NickZ1969/Teensy8x8_Hardware/teensy 8x8/Schematic_Teensy8x8.png

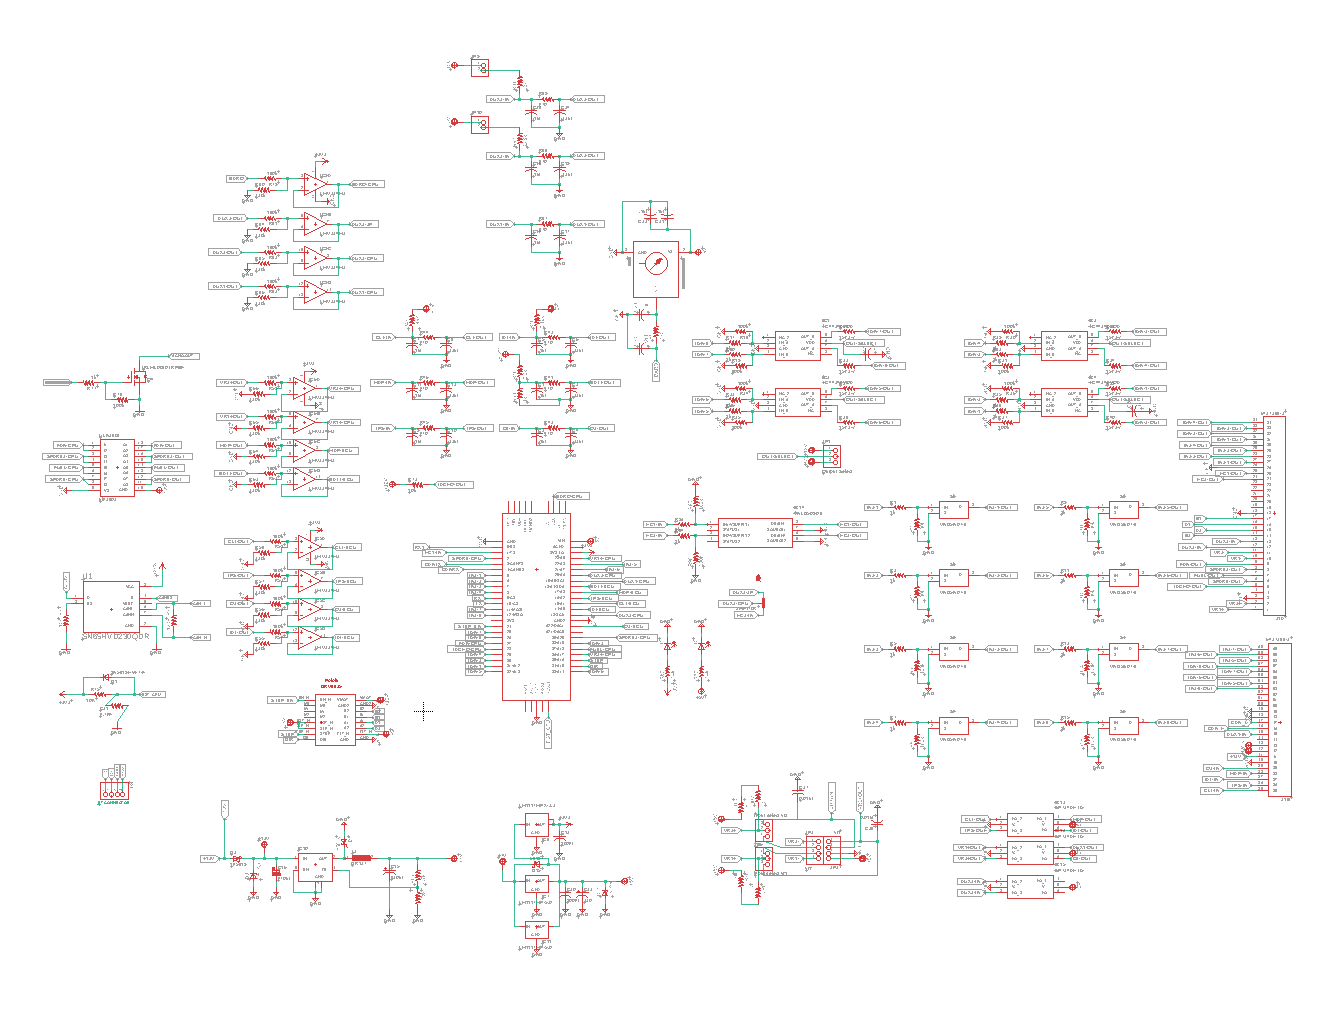
teensy 8x8/Schematic_Teensy8x8.png
