NickZ1969/Teensy8x8_Hardware/teensy 8x8/teensy8x826pin.png

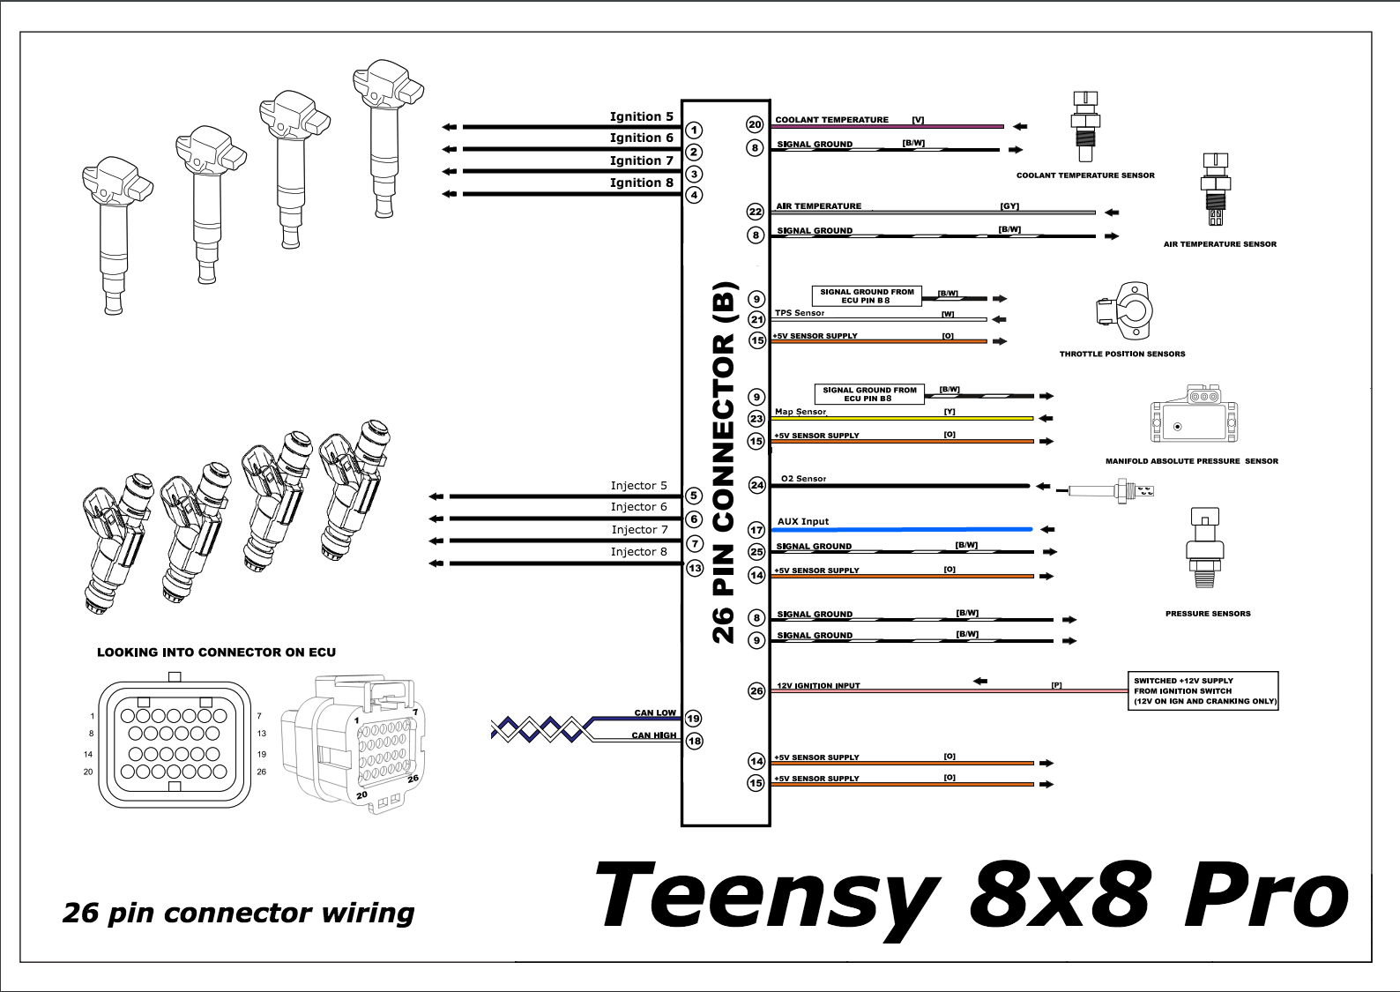
teensy 8x8/teensy8x826pin.png
