NickZ1969/Teensy8x8_Hardware/teensy 8x8/Teensy8x834pin.png

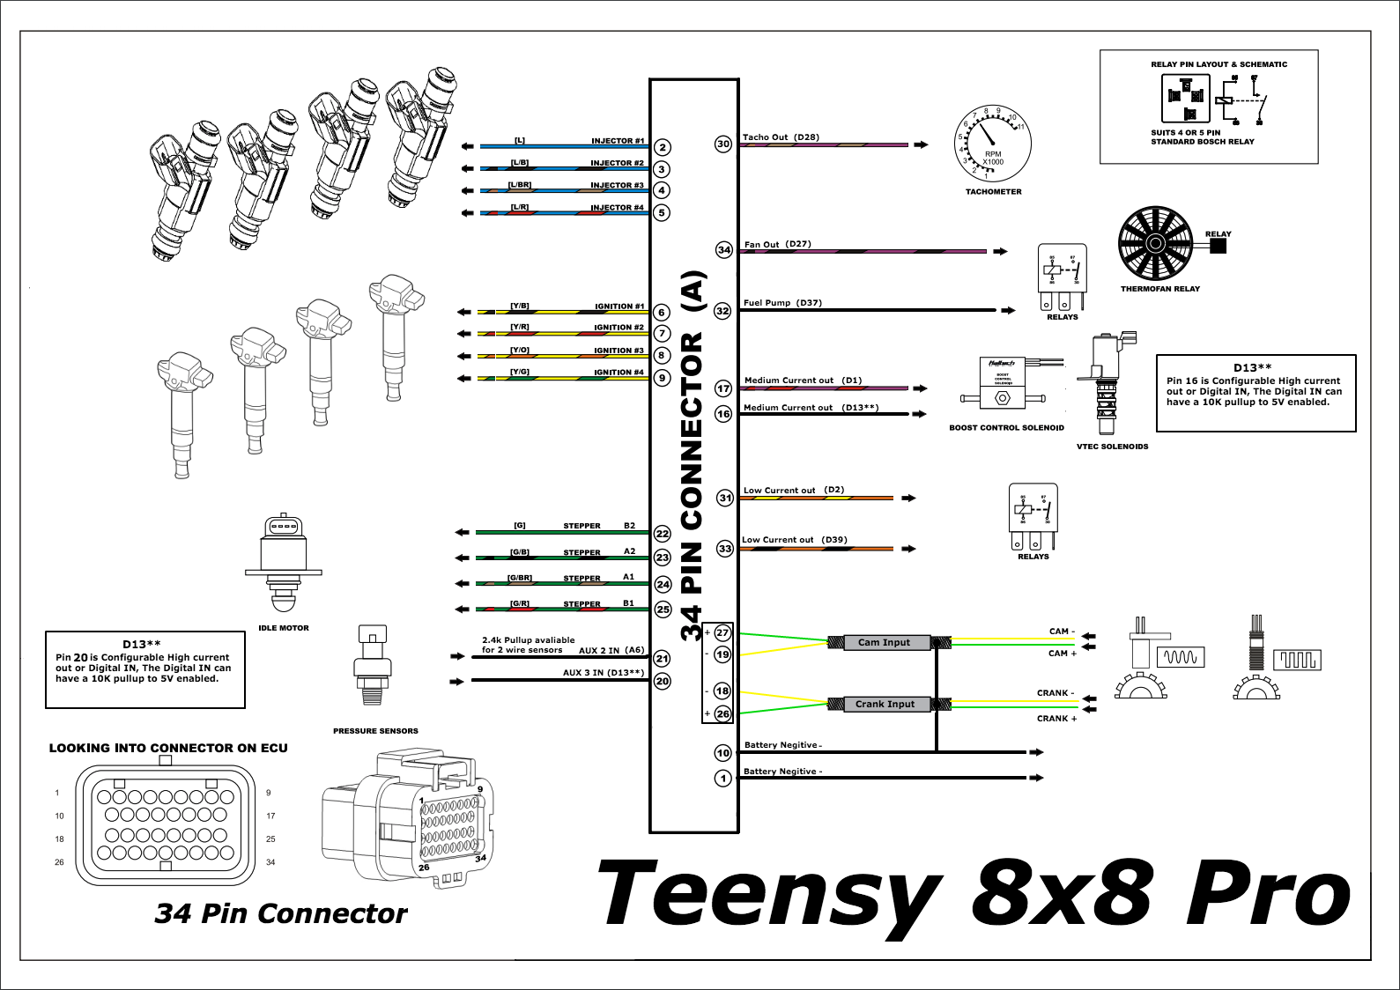
teensy 8x8/Teensy8x834pin.png
