NickZ1969/Teensy8x8_Hardware/teensy 8x8/teensy_speeduino_5.1.brd

## EAGLE design teensy 8x8/teensy_speeduino_5.1.brd (2020-06-06)

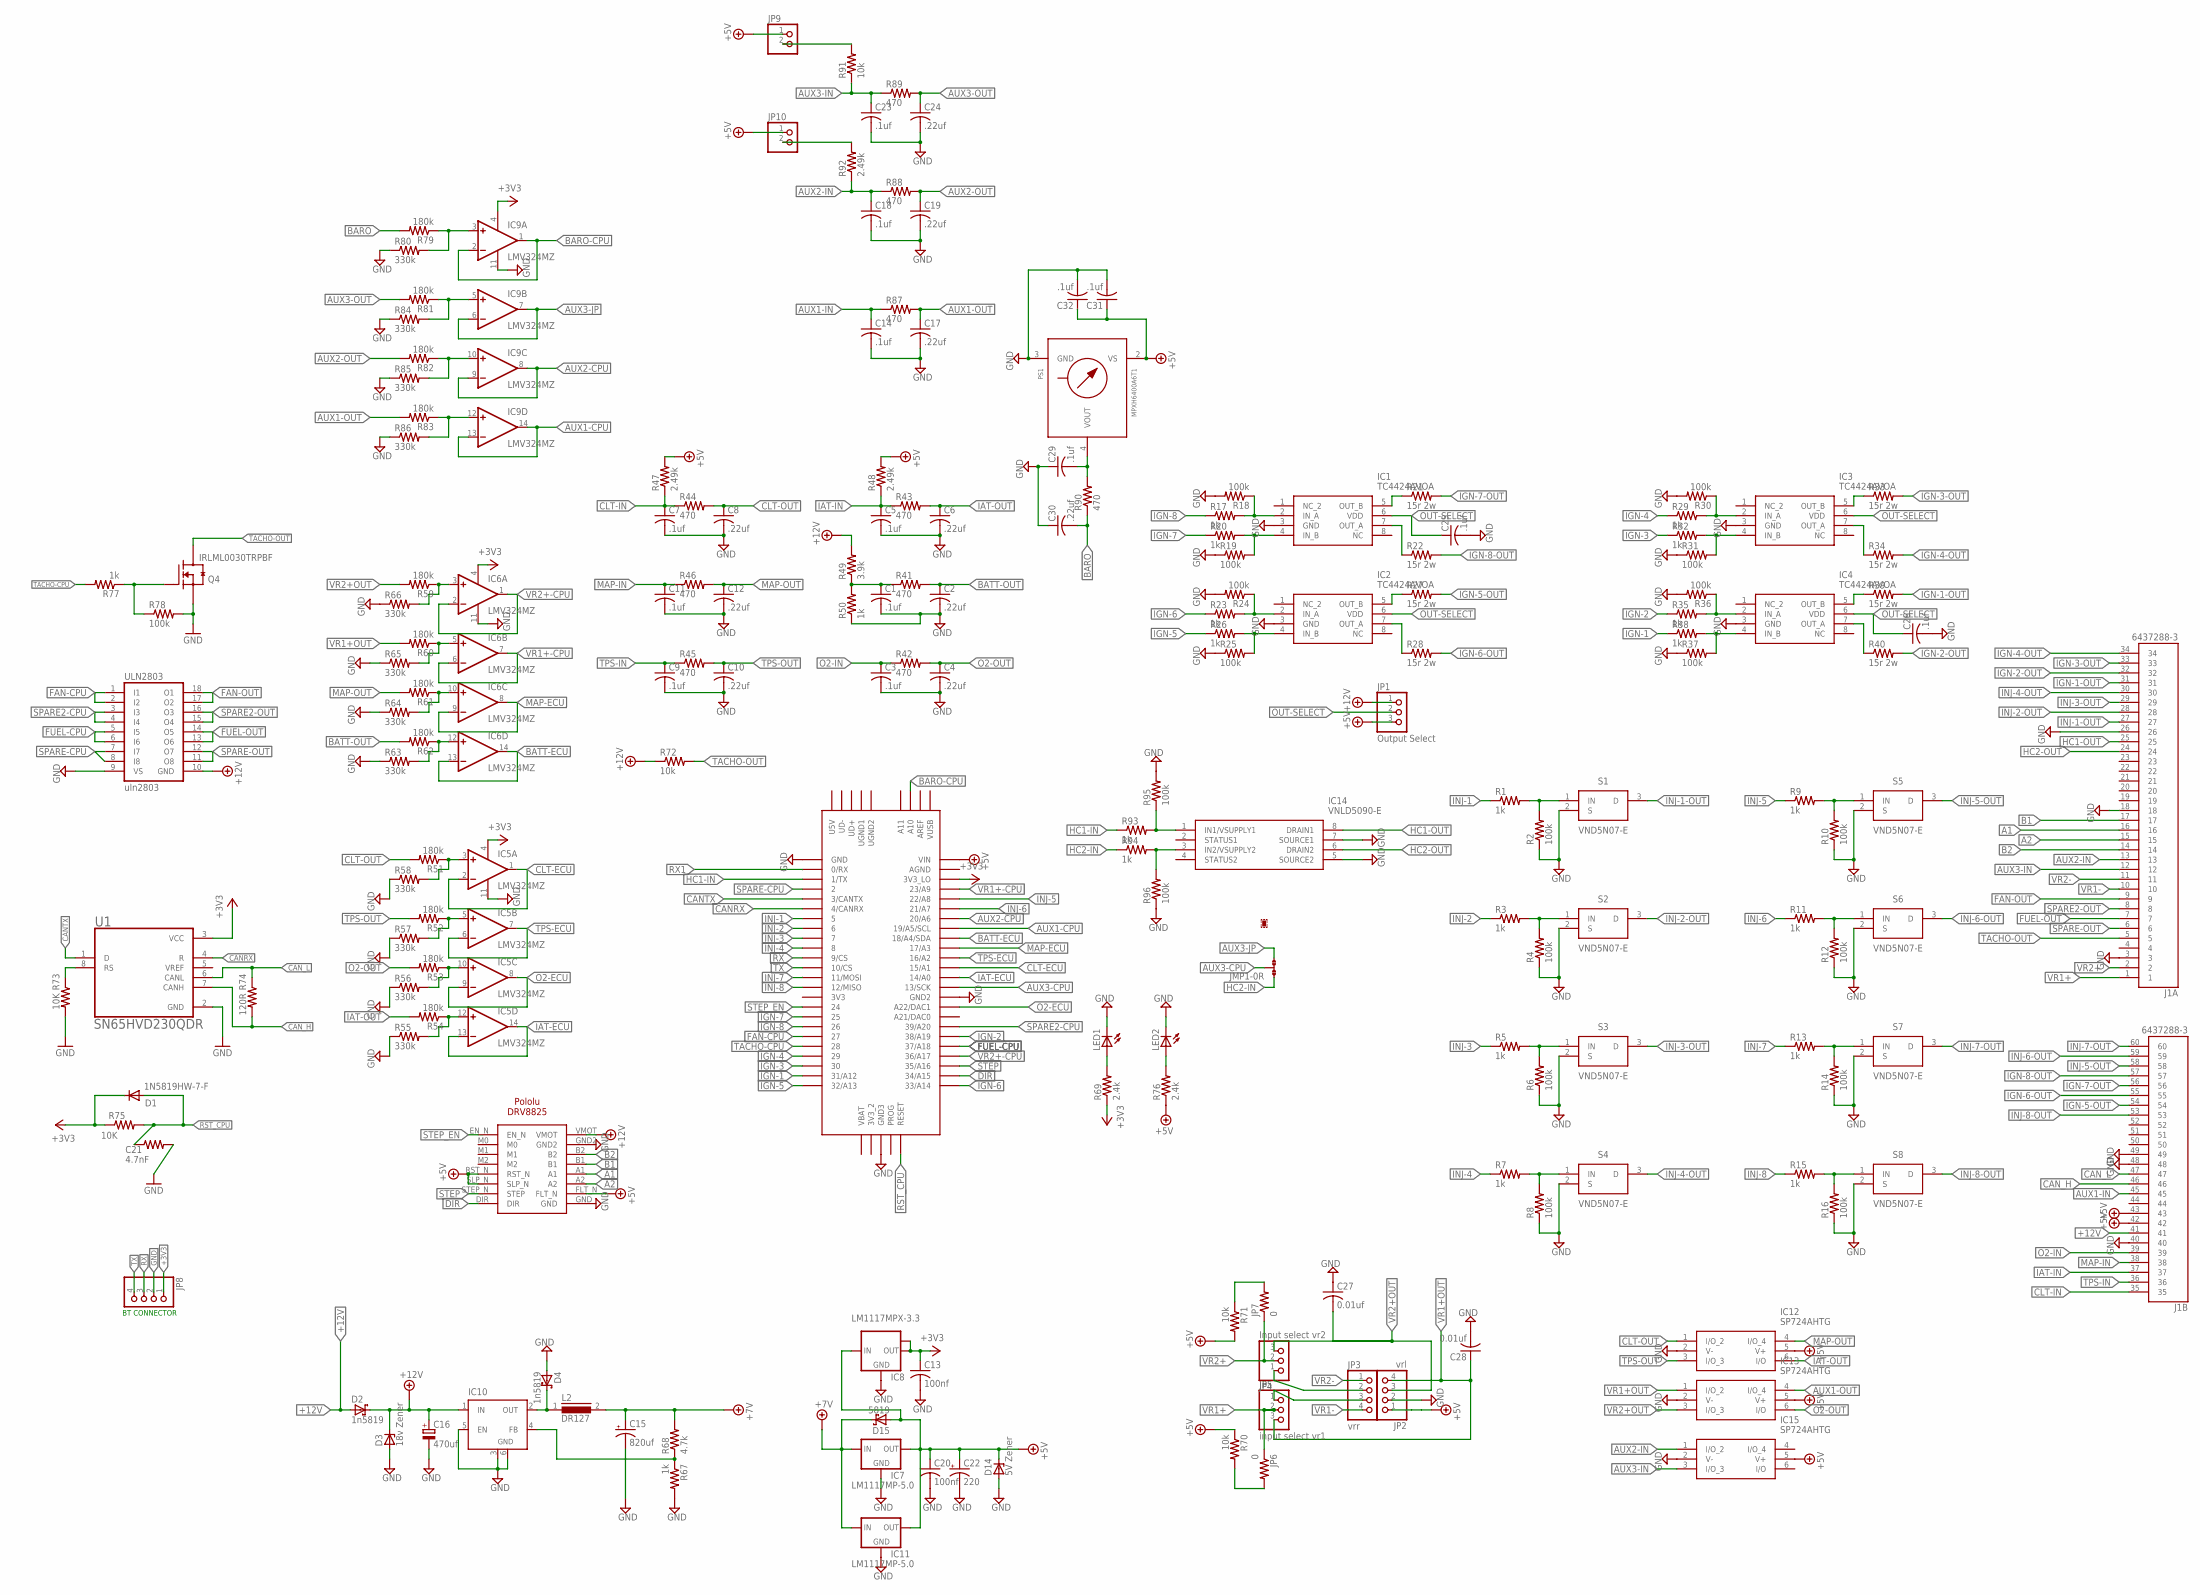
[picture p4: schematic teensy_speeduino_5.1.sch]

Parts:
C1, C3, C5, C7, C9, C11, C29, C31, C32: .1uf; C1206
C2, C4, C6, C8, C10, C12, C30: .22uf; C1206
C13, C20: 100nf; C1206
C14, C18, C23, C25, C26: .1uf; C0805
C15: 820uf; 153CLV-0810
C16: 470uf; 153CLV-0810
C17, C19, C24: .22uf; C0805
C21: 4.7nF; R1206
C22: 220; 153CLV-0605
C27, C28: 0.01uf; C1206
D1: 1N5819HW-7-F; SOD123
D2, D4: 1n5819; SMB
D3: 18v Zener; SMB
D14: 5V Zener; SMB
D15: 5819; SMB
IC1, IC2, IC3, IC4: TC4424AVOA; SOIC127P600X175-8N
IC5, IC6, IC9: LMV324MZ; TSSOP14
IC7, IC11: LM1117MP-5.0; SOT223
IC8: LM1117MPX-3.3; SOT223
IC10: LM2596S; TO263-5
IC12, IC13, IC15: SP724AHTG; SOT95P280X145-6N
IC14: VNLD5090-E; SOIC127P600X175-8N
J1: 6437288-3; TE_6437288-3
JMP1: 0R-JUMPA; A0R-JMP
JP1: Output Select; 1X03
JP2: vrl; 1X04
JP3: vrr; 1X04
JP4: Input select vr2; 1X03
JP5: input select vr1; 1X03
JP6, JP7: 0; R0805
JP8: PINHD-1X4; 1X04
JP9, JP10: PINHD-1X2; 1X02
L2: DR127
LED1, LED2: LEDSML1206; SML1206
PS1: MPXH6400A6T1; 1317
Q4: IRLML0030TRPBF; SOT95P280X135-3N
R1, R3, R5, R7, R9, R11, R13, R15, R17, R20, R23, R26, R29, R32, R35, R38, R50, R67, R77, R93, R94: 1k; R1206
R2, R4, R6, R8, R10, R12, R14, R16, R18, R19, R24, R25, R30, R31, R36, R37, R78, R95, R96: 100k; R1206
R21, R22, R27, R28, R33, R34, R39, R40: 15r 2w; R2512
R41, R42, R43, R44, R45, R46, R90: 470; R1206
R47, R48, R92: 2.49k; R1206
R49: 3.9k; R1206
R51, R52, R53, R54, R59, R60, R61, R62: 180k; R1206
R55, R56, R57, R58, R63, R64, R65, R66: 330k; R1206
R68: 4.7k; R1206
R69, R76: 2.4k; R1206
R70, R71, R72, R91: 10k; R1206
R73, R75: 10K; R1206
R74: 120R; R1206
R79, R81, R82, R83: 180k; R0805
R80, R84, R85, R86: 330k; R0805
R87, R88, R89: 470; R0805
S1, S2, S3, S4, S5, S6, S7, S8: VND5N07-E; TO-252-(DPAK)_1
U1: SN65HVD230QDR; SOIC127P600X175-8N
U$1: TEENSY_3.5/3.6
U$3: POLOLU-DRV8825
ULN2803: uln2803; SO18W

Connections:
+3V3: C13.1, D1.C, IC5.4 (V+), IC6.4 (V+), IC8.2 (OUT), IC8.TAB (OUT1), IC9.4 (V+), JP8.1, R69.1, R75.1, U1.3 (VCC), U$1.3V3_LO
+5V: C20.1, C22.+, C31.1, C32.1, D14.C, D15.A, IC7.2 (OUT), IC7.4 (OUT), IC8.3 (IN), IC11.2 (OUT), IC11.4 (OUT), IC12.5 (V+), IC13.5 (V+), IC15.5 (V+), J1.42, J1.43, JP1.3, JP2.1, JP9.1, JP10.1, PS1.2 (VS), R47.2, R48.2, R70.1, R71.2, R76.1, U$1.VIN, U$3.FLT_N, U$3.RST_N, U$3.SLP_N
+7V: C15.+, D15.C, IC7.3 (IN), IC11.3 (IN), L2.2, R68.2
+12V: C16.+, D2.A, D2.C, D3.C, IC10.1 (IN), J1.41, JP1.1, R49.2, R72.1, U$3.VMOT, ULN2803.10 (GND)
A1: J1.16, U$3.A1
A2: J1.15, U$3.A2
AUX1-CPU: IC9.13 (-IN), IC9.14 (OUT), U$1.19/A5/SCL
AUX1-IN: C14.1, J1.45, R87.1
AUX1-OUT: C17.1, IC13.4 (I/O_4), R83.2, R87.2
AUX2-CPU: IC9.8 (OUT), IC9.9 (-IN), U$1.20/A6
AUX2-IN: C18.1, IC15.1 (I/O_2), J1.13, R88.1, R92.1
AUX2-OUT: C19.1, R82.2, R88.2
AUX3-CPU: JMP1.2, U$1.13/SCK
AUX3-IN: C23.1, IC15.3 (I/O_3), J1.12, R89.1, R91.1
AUX3-JP: IC9.6 (-IN), IC9.7 (OUT), JMP1.3
AUX3-OUT: C24.1, R81.2, R89.2
B1: J1.17, U$3.B1
B2: J1.14, U$3.B2
BARO: C30.2, R79.2, R90.1
BARO-CPU: IC9.1 (OUT), IC9.2 (-IN), U$1.A10
BATT-ECU: IC6.13 (-IN), IC6.14 (OUT), U$1.18/A4/SDA
BATT-OUT: C2.1, R41.2, R62.2
CANRX: U1.4 (R), U$1.4/CANRX
CANTX: U1.1 (D), U$1.3/CANTX
CAN_H: J1.46, R74.2, U1.7 (CANH)
CAN_L: J1.47, R74.1, U1.6 (CANL)
CLT-ECU: IC5.1 (OUT), IC5.2 (-IN), U$1.15/A1
CLT-IN: C7.1, J1.35, R44.1, R47.1
CLT-OUT: C8.1, IC12.1 (I/O_2), R44.2, R51.2
DIR: U$1.34/A15, U$3.DIR
FAN-CPU: U$1.27, ULN2803.1 (I1), ULN2803.2 (I2)
FAN-OUT: J1.9, ULN2803.17 (O2), ULN2803.18 (O1)
FUEL-CPU: U$1.37/A18, ULN2803.5 (I5), ULN2803.6 (I6)
FUEL-OUT: J1.7, ULN2803.13 (O6), ULN2803.14 (O5)
GND: C1.2, C2.2, C3.2, C4.2, C5.2, C6.2, C7.2, C8.2, C9.2, C10.2, C11.2, C12.2, C13.2, C14.2, C15.-, C16.-, C17.2, C18.2, C19.2, C20.2, C21.2, C22.-, C23.2, C24.2, C25.2, C26.2, C27.1, C28.2, C29.1, C30.1, C31.2, C32.2, D3.A, D4.A, D14.A, IC1.3 (GND), IC2.3 (GND), IC3.3 (GND), IC4.3 (GND), IC5.11 (V-), IC6.11 (V-), IC7.1 (GND), IC8.1 (GND), IC9.11 (V-), IC10.3 (GND), IC10.5 (EN), IC10.6 (GND), IC11.1 (GND), IC12.2 (V-), IC13.2 (V-), IC14.5 (SOURCE2), IC14.7 (SOURCE1), IC15.2 (V-), J1.3, J1.18, J1.26, J1.40, J1.48, J1.49, JP2.2, JP8.2, LED1.C, LED2.C, PS1.3 (GND), Q4.2 (S), R2.1, R4.1, R6.1, R8.1, R10.1, R12.1, R14.1, R16.1, R18.2, R19.1, R24.2, R25.1, R30.2, R31.1, R36.2, R37.1, R50.1, R55.1, R56.1, R57.1, R58.1, R63.1, R64.1, R65.1, R66.1, R67.2, R73.2, R78.2, R80.1, R84.1, R85.1, R86.1, R95.2, R96.1, S1.2 (S), S2.2 (S), S3.2 (S), S4.2 (S), S5.2 (S), S6.2 (S), S7.2 (S), S8.2 (S), U1.2 (GND), U$1.GND, U$1.GND2, U$1.GND3, U$3.GND, U$3.GND2, ULN2803.9 (VS)
HC1-IN: R93.1, U$1.1/TX
HC1-OUT: IC14.8 (DRAIN1), J1.25
HC2-IN: JMP1.1, R94.1
HC2-OUT: IC14.6 (DRAIN2), J1.24
IAT-ECU: IC5.13 (-IN), IC5.14 (OUT), U$1.14/A0
IAT-IN: C5.1, J1.37, R43.1, R48.1
IAT-OUT: C6.1, IC12.6 (I/O), R43.2, R54.2
IGN-1: R38.1, U$1.31/A12
IGN-1-OUT: J1.31, R39.2
IGN-2: R35.1, U$1.38/A19
IGN-2-OUT: J1.32, R40.2
IGN-3: R32.1, U$1.30
IGN-3-OUT: J1.33, R33.2
IGN-4: R29.1, U$1.29
IGN-4-OUT: J1.34, R34.2
IGN-5: R26.1, U$1.32/A13
IGN-5-OUT: J1.54, R27.2
IGN-6: R23.1, U$1.33/A14
IGN-6-OUT: J1.55, R28.2
IGN-7: R20.1, U$1.25
IGN-7-OUT: J1.56, R21.2
IGN-8: R17.1, U$1.26
IGN-8-OUT: J1.57, R22.2
INJ-1: R1.1, U$1.5
INJ-1-OUT: J1.27, S1.3 (D)
INJ-2: R3.1, U$1.6
INJ-2-OUT: J1.28, S2.3 (D)
INJ-3: R5.1, U$1.7
INJ-3-OUT: J1.29, S3.3 (D)
INJ-4: R7.1, U$1.8
INJ-4-OUT: J1.30, S4.3 (D)
INJ-5: R9.1, U$1.22/A8
INJ-5-OUT: J1.58, S5.3 (D)
INJ-6: R11.1, U$1.21/A7
INJ-6-OUT: J1.59, S6.3 (D)
INJ-7: R13.1, U$1.11/MOSI
INJ-7-OUT: J1.60, S7.3 (D)
INJ-8: R15.1, U$1.12/MISO
INJ-8-OUT: J1.53, S8.3 (D)
MAP-ECU: IC6.8 (OUT), IC6.9 (-IN), U$1.17/A3
MAP-IN: C11.1, J1.38, R46.1
MAP-OUT: C12.1, IC12.4 (I/O_4), R46.2, R61.2
unnamed: R1.2, R2.2, S1.1 (IN)
unnamed: R3.2, R4.2, S2.1 (IN)
unnamed: JP3.3, JP5.1
unnamed: JP6.2, R70.2
unnamed: LED2.A, R76.2
unnamed: JP7.2, R71.1
unnamed: R5.2, R6.2, S3.1 (IN)
unnamed: IC1.7 (OUT_A), R22.1
unnamed: IC10.4 (FB), R67.1, R68.1
unnamed: R7.2, R8.2, S4.1 (IN)
unnamed: D4.C, IC10.2 (OUT), L2.1
unnamed: R73.1, U1.8 (RS)
unnamed: R9.2, R10.2, S5.1 (IN)
unnamed: LED1.A, R69.2
unnamed: Q4.1 (G), R77.1, R78.1
unnamed: R11.2, R12.2, S6.1 (IN)
unnamed: IC2.7 (OUT_A), R28.1
unnamed: IC9.3 (+IN), R79.1, R80.2
unnamed: R13.2, R14.2, S7.1 (IN)
unnamed: IC3.7 (OUT_A), R34.1
unnamed: JP10.2, R92.2
unnamed: R15.2, R16.2, S8.1 (IN)
unnamed: IC4.7 (OUT_A), R40.1
unnamed: C29.2, PS1.4 (VOUT), R90.2
unnamed: IC1.2 (IN_A), R17.2, R18.1
unnamed: IC1.4 (IN_B), R19.2, R20.2
unnamed: IC1.5 (OUT_B), R21.1
unnamed: IC14.1 (IN1/VSUPPLY1), R93.2, R95.1
unnamed: IC2.2 (IN_A), R23.2, R24.1
unnamed: IC2.4 (IN_B), R25.2, R26.2
unnamed: IC2.5 (OUT_B), R27.1
unnamed: JP3.2, JP4.1
unnamed: IC3.2 (IN_A), R29.2, R30.1
unnamed: IC3.4 (IN_B), R31.2, R32.2
unnamed: IC3.5 (OUT_B), R33.1
unnamed: IC14.3 (IN2/VSUPPLY2), R94.2, R96.2
unnamed: IC4.2 (IN_A), R35.2, R36.1
unnamed: IC4.4 (IN_B), R37.2, R38.2
unnamed: IC4.5 (OUT_B), R39.1
unnamed: JP9.2, R91.2
unnamed: IC6.3 (+IN), R59.1, R66.2
unnamed: C1.1, R41.1, R49.1, R50.2
unnamed: IC5.3 (+IN), R51.1, R58.2
unnamed: IC5.5 (+IN), R52.1, R57.2
unnamed: IC5.10 (+IN), R53.1, R56.2
unnamed: IC5.12 (+IN), R54.1, R55.2
unnamed: IC9.5 (+IN), R81.1, R84.2
unnamed: IC6.5 (+IN), R60.1, R65.2
unnamed: IC6.10 (+IN), R61.1, R64.2
unnamed: IC6.12 (+IN), R62.1, R63.2
unnamed: IC9.10 (+IN), R82.1, R85.2
unnamed: IC9.12 (+IN), R83.1, R86.2
O2-ECU: IC5.8 (OUT), IC5.9 (-IN), U$1.A22/DAC1
O2-IN: C3.1, J1.39, R42.1
O2-OUT: C4.1, IC13.6 (I/O), R42.2, R53.2
OUT-SELECT: C25.1, C26.1, IC1.6 (VDD), IC2.6 (VDD), IC3.6 (VDD), IC4.6 (VDD), JP1.2
RST_CPU: C21.1, D1.A, R75.2, U$1.RESET
RX: JP8.3, U$1.9/CS
RX1: U$1.0/RX
SPARE2-CPU: U$1.39/A20, ULN2803.3 (I3), ULN2803.4 (I4)
SPARE2-OUT: J1.8, ULN2803.15 (O4), ULN2803.16 (O3)
SPARE-CPU: U$1.2, ULN2803.7 (I7), ULN2803.8 (I8)
SPARE-OUT: J1.6, ULN2803.11 (O8), ULN2803.12 (O7)
STEP: U$1.35/A16, U$3.STEP_N (STEP)
STEP_EN: U$1.24, U$3.EN_N
TACHO-CPU: R77.2, U$1.28
TACHO-OUT: J1.5, Q4.3 (D), R72.2
TPS-ECU: IC5.6 (-IN), IC5.7 (OUT), U$1.16/A2
TPS-IN: C9.1, J1.36, R45.1
TPS-OUT: C10.1, IC12.3 (I/O_3), R45.2, R52.2
TX: JP8.4, U$1.10/CS
VR1+: J1.1, JP5.2, JP6.1
VR1+-CPU: IC6.6 (-IN), IC6.7 (OUT), U$1.23/A9
VR1+OUT: C28.1, IC13.1 (I/O_2), JP2.4, JP5.3, R60.2
VR1-: J1.10, JP3.4
VR2+: J1.2, JP4.2, JP7.1
VR2+-CPU: IC6.1 (OUT), IC6.2 (-IN), U$1.36/A17
VR2+OUT: C27.2, IC13.3 (I/O_3), JP2.3, JP4.3, R59.2
VR2-: J1.11, JP3.1

Notes on the sheet:
BT CONNECTOR

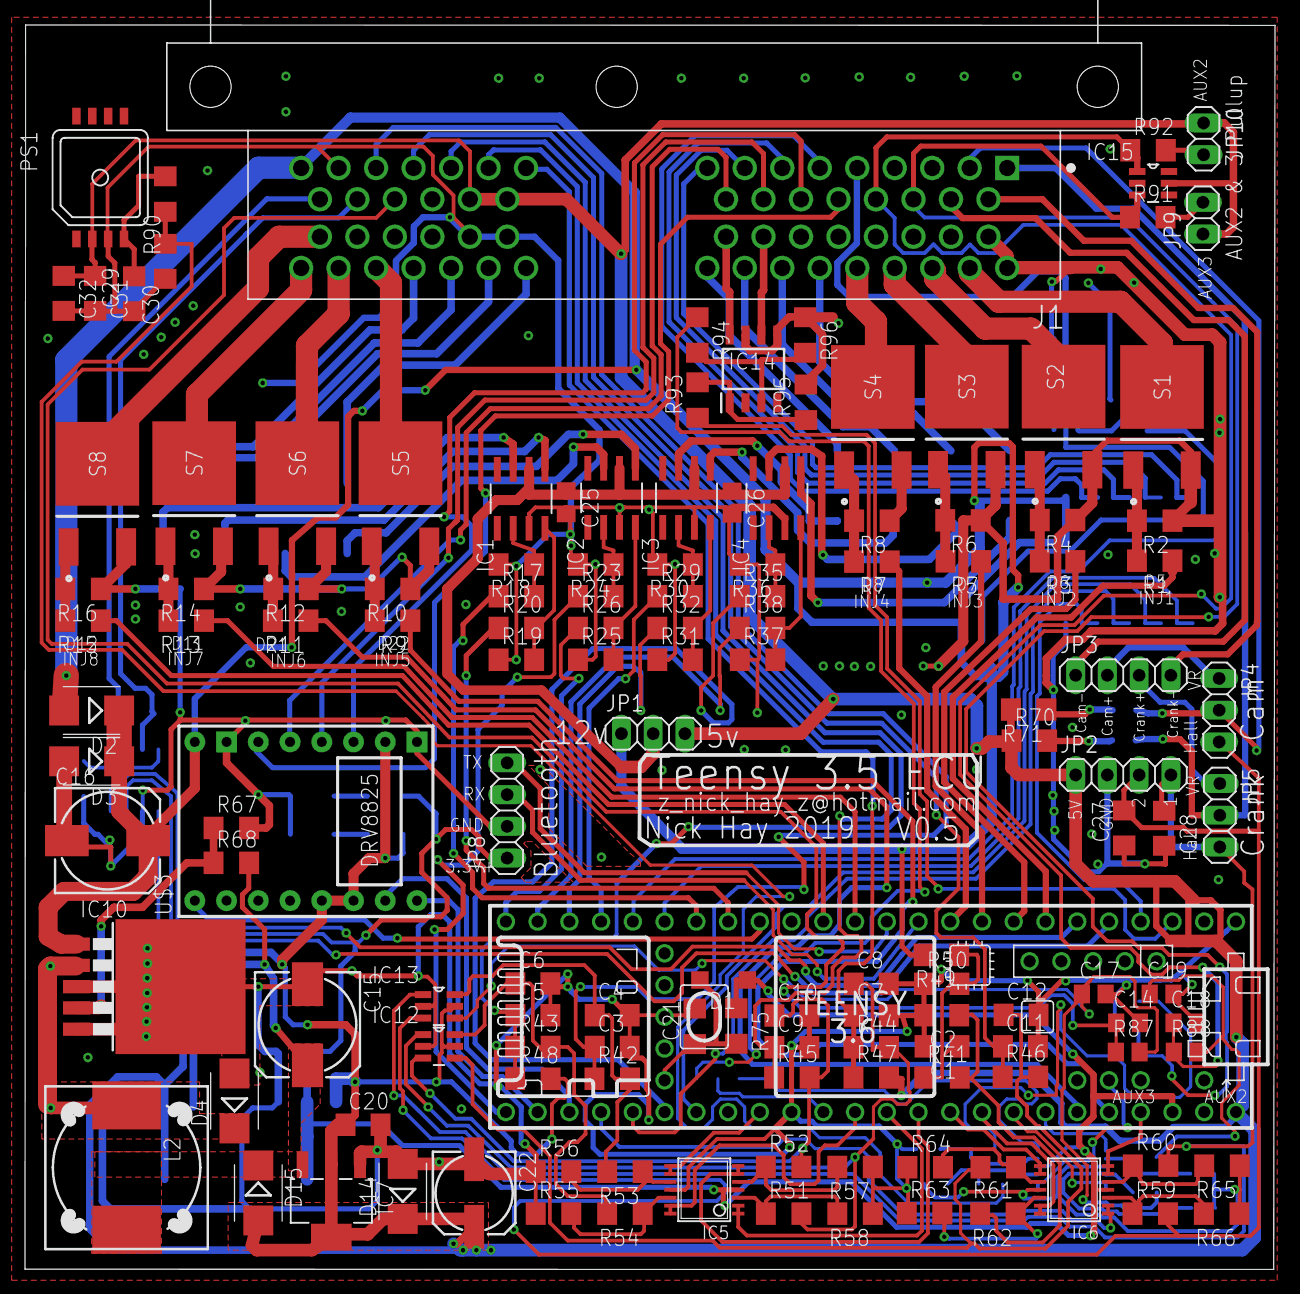
[picture p5: board teensy_speeduino_5.1.brd from above]

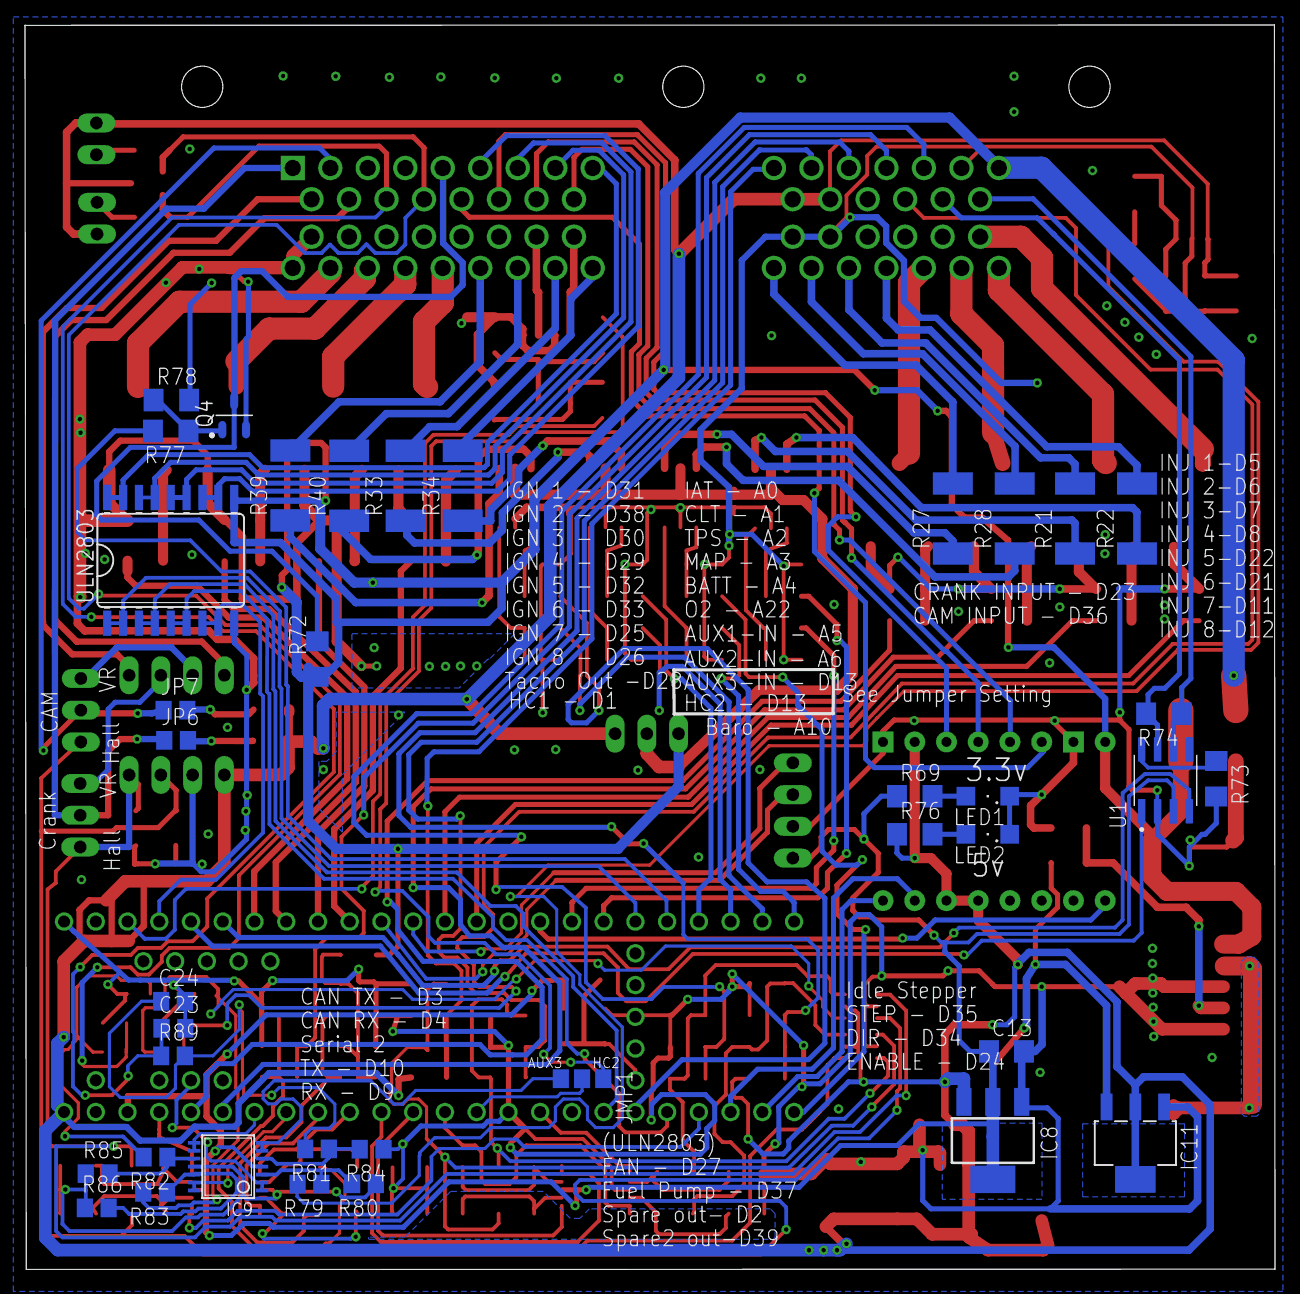
[picture p6: board teensy_speeduino_5.1.brd from below]

Board: 2 copper layers, 100.0 x 99.6 mm, 178 parts (38 on the bottom side), 155 nets.
